morrowsend/PnP-Focus/lasercut_PnP_Focus_Stick.dxf

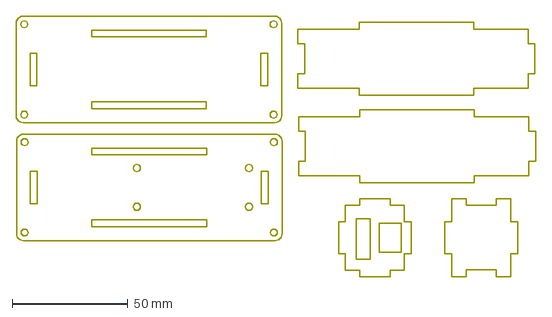
[picture p38: CAD file, 2020-10-31]
lasercut_PnP_Focus_Stick.dxf
224.7 x 112.7 mm
