morrowsend/PnP-Focus/lasercut_PnP_Focus.dxf

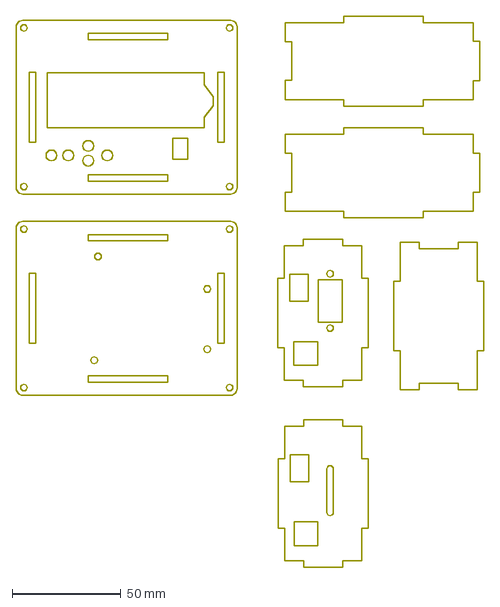
[picture p39: CAD file, 2020-10-31]
lasercut_PnP_Focus.dxf
215.4 x 253.8 mm
