morrowsend/PnP-Focus/(commit log)

2020-10-31 Added laser cut files
    Added Anat's laser cut files so they are available in the same repository locaiton.
    [lasercut_PnP_Focus.dxf, lasercut_PnP_Focus_Stick.dxf]
2020-10-31 revised the zip file contents
    Added the laser cut files to the zipped file
2020-11-01 2.0Error update
    Resturture files so they will compile for people, fix the half stepping problem, correct documentation about half stepping issues
    [ArdumotoStepper.cpp, ArdumotoStepper.h, DallasTemperature.cpp, DallasTemperature.h, Moonlite.cpp, Moonlite.h, OneWire.cpp, OneWire.h]
